Davidmunmen/proyecto_robot/(commit log)

2026-04-29 deteccion de proximitad y top
2026-06-15 Agregue documentos que usamos para el proyecto del robot
